Acookiefor2/Mr.Whoami/schematics/README.md

# Schematics & Wiring
Pinout diagrams and the breadboard wiring schematics and KiCad design files for Mr.Whoami will be uploaded here
