Acookiefor2/Mr.Whoami/CAD/Mr.Whoami-enclosure.step

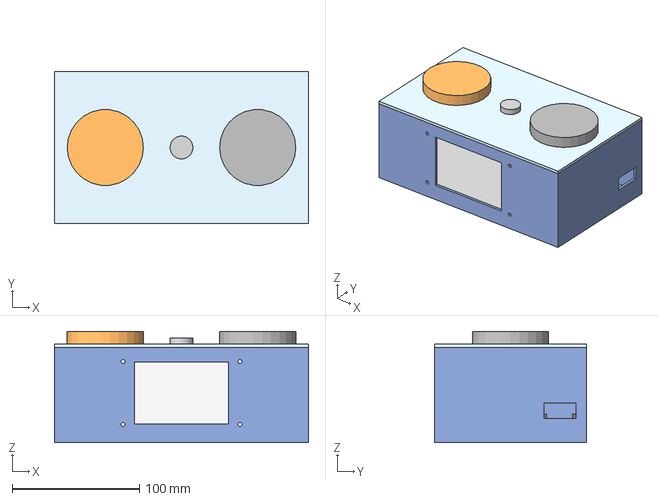
[picture p7: CAD file, 2026-11-07]
CAD/Mr.Whoami-enclosure.step
200.0 x 120.0 x 87.5 mm
