Acookiefor2/Mr.Whoami/CAD/Mr.Whoami.step

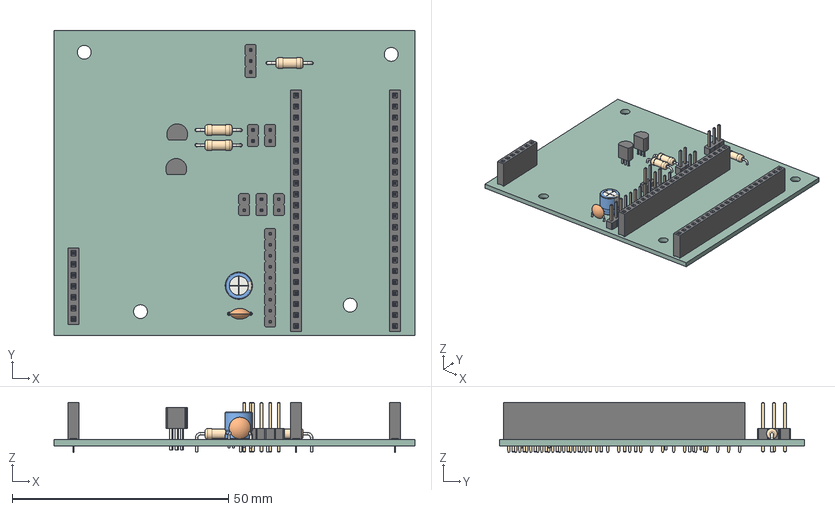
[picture p8: CAD file, 2026-11-05]
CAD/Mr.Whoami.step
83.5 x 70.5 x 11.6 mm
C_Disc_D50mm_W25mm_P500mm
PinHeader_1x03_P254mm_Vertical
PinHeader_1x02_P254mm_Vertical x 5
R_Axial_DIN0207_L63mm_D25mm_P1016mm_Horizontal x 3
TO-92_Inline_Narrow x 2
PinSocket_1x07_P2.54mm_Vertical
PinSocket_1x22_P2.54mm_Vertical x 2
PinHeader_1x09_P254mm_Vertical
CP_Radial_D63mm_P250mm
Mr.Whoami_PCB
