Acookiefor2/Mr.Whoami/schematics/Mr.Whoami/Mr.Whoami.kicad_pcb

## KiCad design schematics/Mr.Whoami/Mr.Whoami.kicad_pcb (2026-11-02)

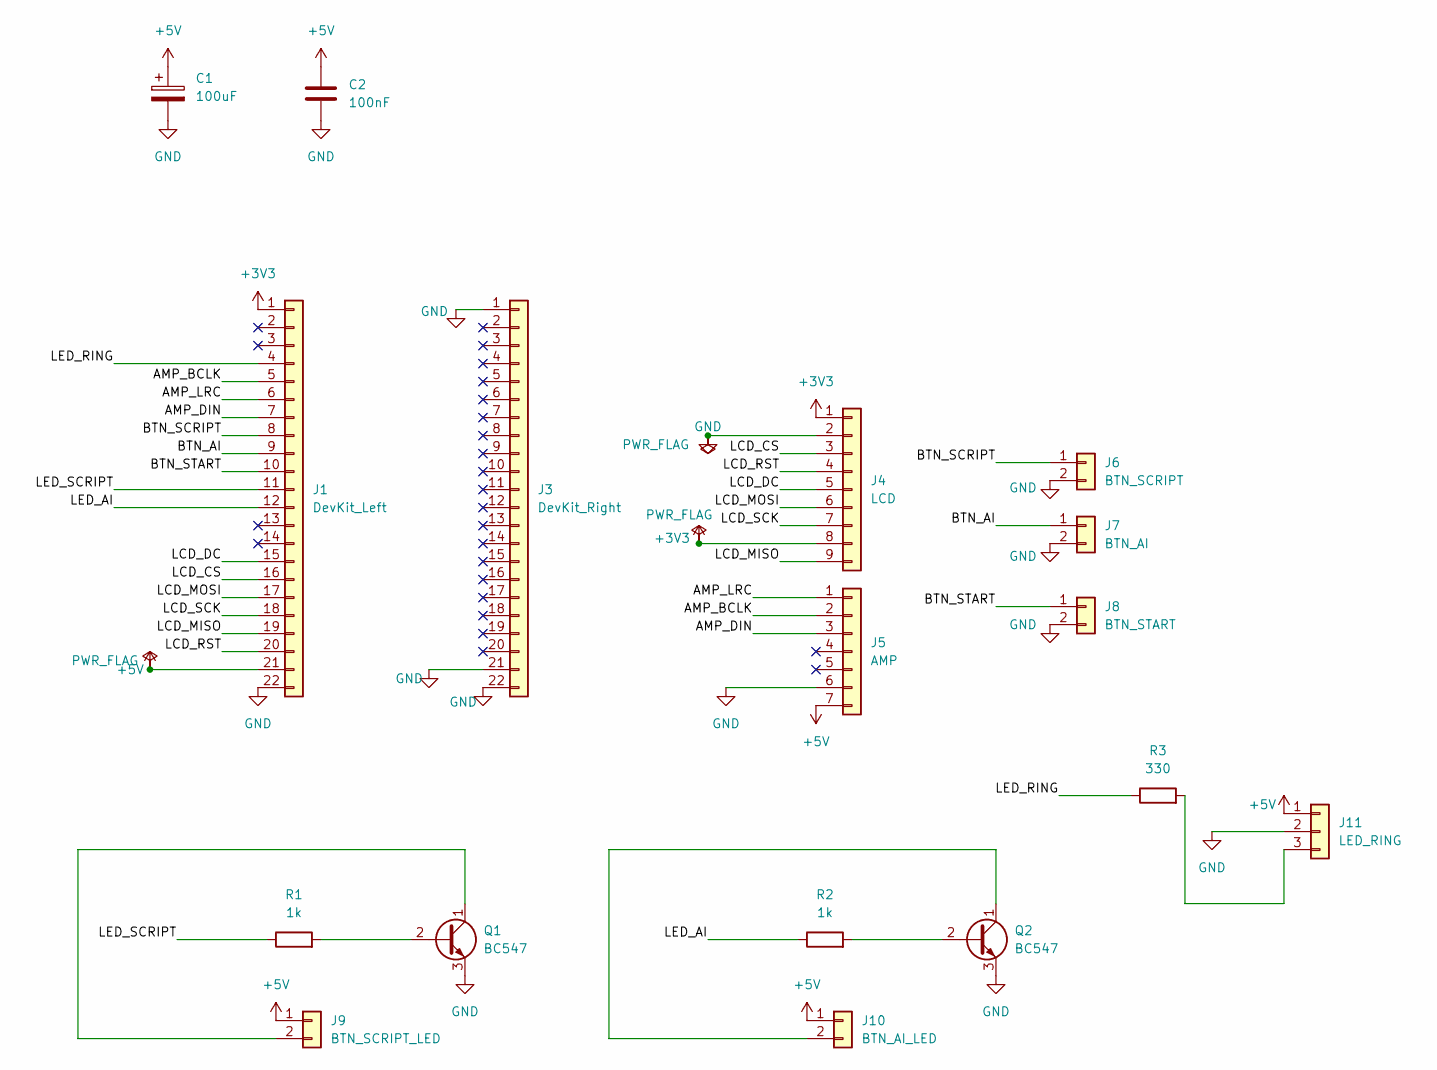
[picture p9: schematic Mr.Whoami.kicad_sch]

Parts:
C1: 100uF; CP_Radial_D6.3mm_P2.50mm
C2: 100nF; C_Disc_D5.0mm_W2.5mm_P5.00mm
J1: DevKit_Left; PinSocket_1x22_P2.54mm_Vertical
J3: DevKit_Right; PinSocket_1x22_P2.54mm_Vertical
J4: LCD; PinHeader_1x09_P2.54mm_Vertical
J5: AMP; PinSocket_1x07_P2.54mm_Vertical
J6: BTN_SCRIPT; PinHeader_1x02_P2.54mm_Vertical
J7: BTN_AI; PinHeader_1x02_P2.54mm_Vertical
J8: BTN_START; PinHeader_1x02_P2.54mm_Vertical
J9: BTN_SCRIPT_LED; PinHeader_1x02_P2.54mm_Vertical
J10: BTN_AI_LED; PinHeader_1x02_P2.54mm_Vertical
J11: LED_RING; PinHeader_1x03_P2.54mm_Vertical
Q1, Q2: BC547; TO-92_Inline
R1, R2: 1k; R_Axial_DIN0207_L6.3mm_D2.5mm_P10.16mm_Horizontal
R3: 330; R_Axial_DIN0207_L6.3mm_D2.5mm_P10.16mm_Horizontal

Connections:
+3V3: J1.1, J4.1, J4.8
+5V: C1.1, C2.1, J1.21, J5.7, J9.1, J10.1, J11.1
/AMP_BCLK: J1.5, J5.2
/AMP_DIN: J1.7, J5.3
/AMP_LRC: J1.6, J5.1
/BTN_AI: J1.9, J7.1
/BTN_SCRIPT: J1.8, J6.1
/BTN_START: J1.10, J8.1
/LCD_CS: J1.16, J4.3
/LCD_DC: J1.15, J4.5
/LCD_MISO: J1.19, J4.9
/LCD_MOSI: J1.17, J4.6
/LCD_RST: J1.20, J4.4
/LCD_SCK: J1.18, J4.7
/LED_AI: J1.12, R2.1
/LED_RING: J1.4, R3.1
/LED_SCRIPT: J1.11, R1.1
GND: C1.2, C2.2, J1.22, J3.1, J3.21, J3.22, J4.2, J5.6, J6.2, J7.2, J8.2, J11.2, Q1.3 (E), Q2.3 (E)
unnamed: J9.2, Q1.1 (C)
unnamed: J10.2, Q2.1 (C)
unnamed: J11.3, R3.2
unnamed: Q1.2 (B), R1.2
unnamed: Q2.2 (B), R2.2

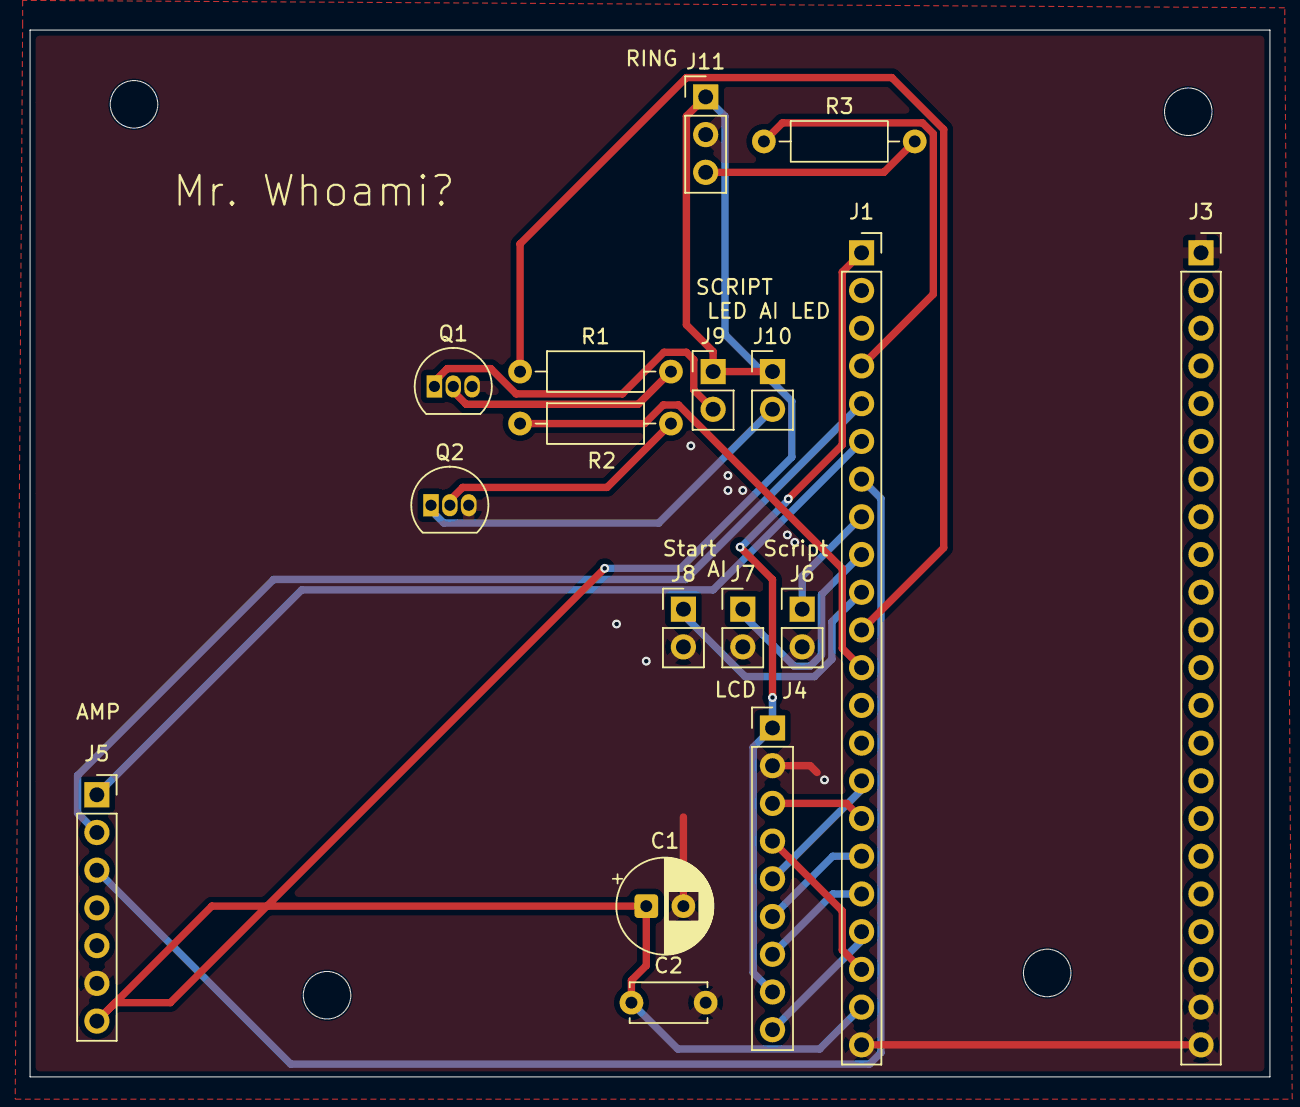
[picture p10: board Mr.Whoami.kicad_pcb from above]

Board: 2 copper layers, 83.5 x 70.5 mm, 21 parts (0 on the bottom side), 23 nets.

Other parts of the board:
H1, H2, H3, H4: MountingHole_3.2mm_M3
