Acookiefor2/Mr.Whoami/(commit log)

2026-10-30 Add BOM.csv with components and costs
    [BOM.csv]
2026-10-30 Add links to components in BOM.csv
    Updated BOM.csv to include links for each component.
    [BOM.csv]
2026-10-30 Add C++ and Arduino related files to .gitignore
2026-10-30 Create README.md for schematics and wiring
    Add initial README for schematics and wiring information
2026-10-30 Initialize Arduino setup with serial output
2026-10-31 Modify BOM.csv after crashout
    Updated BOM with new components and additional notes.
    [BOM.csv]
2026-10-31 Schematic: DevKit headers + screen wiring, ERC clean
    [Mr.Whoami.kicad_pcb, Mr.Whoami.kicad_sch]
2026-11-01 Modify BOM.csv with updated descriptions and new parts
    Updated descriptions for JST-XH connector kit and added new components including BC547 NPN transistor, resistors, and capacitors.
    [BOM.csv]
2026-11-01 Schematic complete: amp, buttons, LED drivers, ring, caps
    [Mr.Whoami.kicad_sch]
2026-11-01 Gitignore KiCad junk, update project file
2026-11-02 PCB AND WIRING DONEEEEEEEEEEEEEE
    [Mr.Whoami.kicad_pcb, Mr.Whoami.kicad_sch]
2026-11-02 Final PCB
    [Mr.Whoami-B_Cu.gbr, Mr.Whoami-B_Mask.gbr, Mr.Whoami-B_Paste.gbr, Mr.Whoami-B_Silkscreen.gbr, Mr.Whoami-Edge_Cuts.gbr, Mr.Whoami-F_Cu.gbr, Mr.Whoami-F_Mask.gbr, Mr.Whoami-F_Paste.gbr]
2026-11-04 Add pictures of schematic and PCB layout
    Added images and descriptions for schematic, PCB layout, and 3D views.
2026-11-05 Add PCB STEP export for enclosure model
    [Mr.Whoami.step]
2026-11-07 Add Onshape enclosure model, STEP export and screenshots
    [Mr.Whoami-enclosure.step]
